chili-chip/chili-utility-module-hardware/3d-models/Vybronics_VZ43FC1B5640007L.step

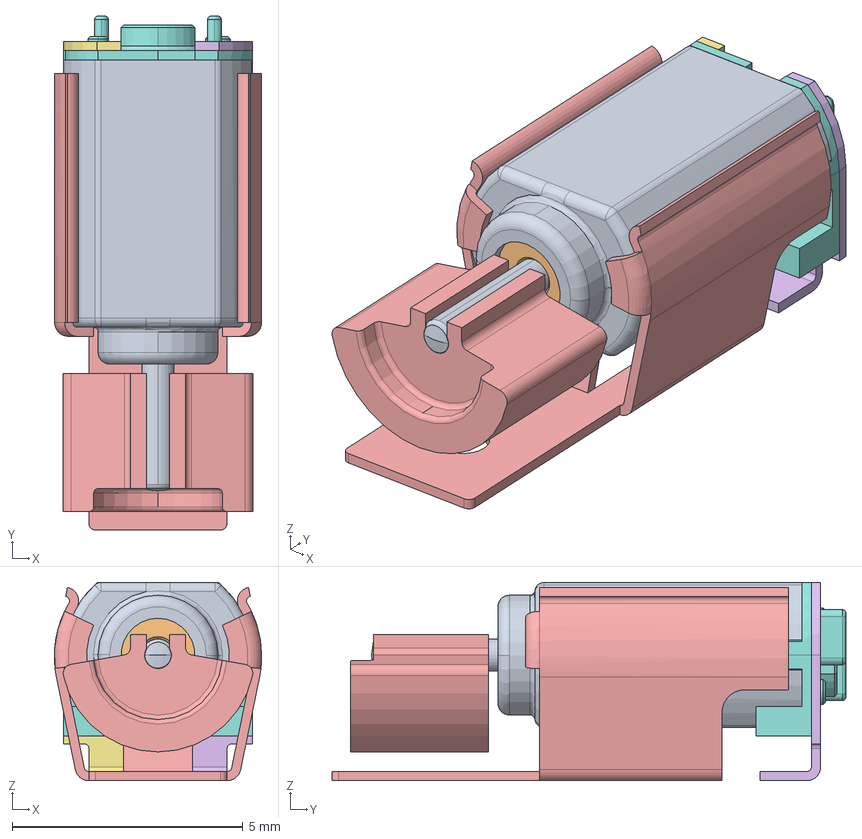
[picture p4: CAD file, 2026-11-06]
3d-models/Vybronics_VZ43FC1B5640007L.step
4.50 x 11.2 x 4.30 mm
SHAFT
PRT0004_1
VARISTOR
WASHER
PRT0004
CP-M_3
CP-M_8
CP-M_1
CP-M_6
CP-M_1_1
CP-M_4
CP-M_10
CP-M
CP-M_9
CP-M_2
CP-M_5
CP-M_12
CP-M_11
CP-M_7
CP-M_1_2
CP-T
COMSLIAO
TAOHUAN
COMTONGP_2
COMTONGP_1
COMTONGP
ZHI_JIA
CASE
METAL_C
MAGNET
MAGNET_1
COUNTER_WEIGHT
BRUSH_SHUATI
BRUSH_CASE
BRUSH_BOARD
BRUSH_CASE-1
BRUSH_SHUATI-1
METAL_E
