chili-chip/chili-utility-module-hardware/3d-models/BatteryHolder_MYOUNG_MY-1220-03.step

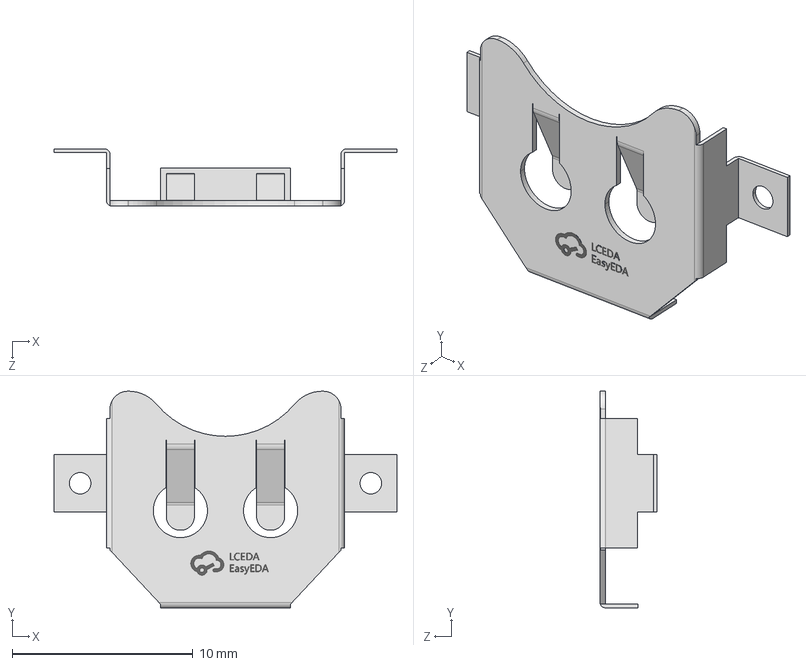
[picture p5: CAD file, 2026-11-05]
3d-models/BatteryHolder_MYOUNG_MY-1220-03.step
19.0 x 12.0 x 3.18 mm
