chili-chip/chili-utility-module-hardware/3d-models/Motor_ERM_LEADER_LCM1027A2445F.step

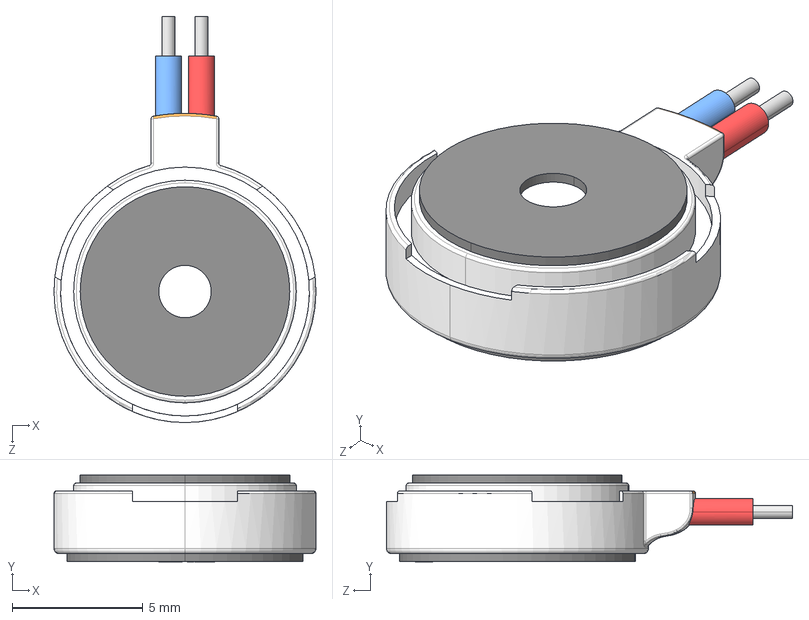
[picture p6: CAD file, 2026-11-05]
3d-models/Motor_ERM_LEADER_LCM1027A2445F.step
10.0 x 3.31 x 15.5 mm
