chili-chip/chili-utility-module-hardware/chili-utility-module.kicad_pcb

## KiCad design chili-utility-module.kicad_pcb (2026-11-05)

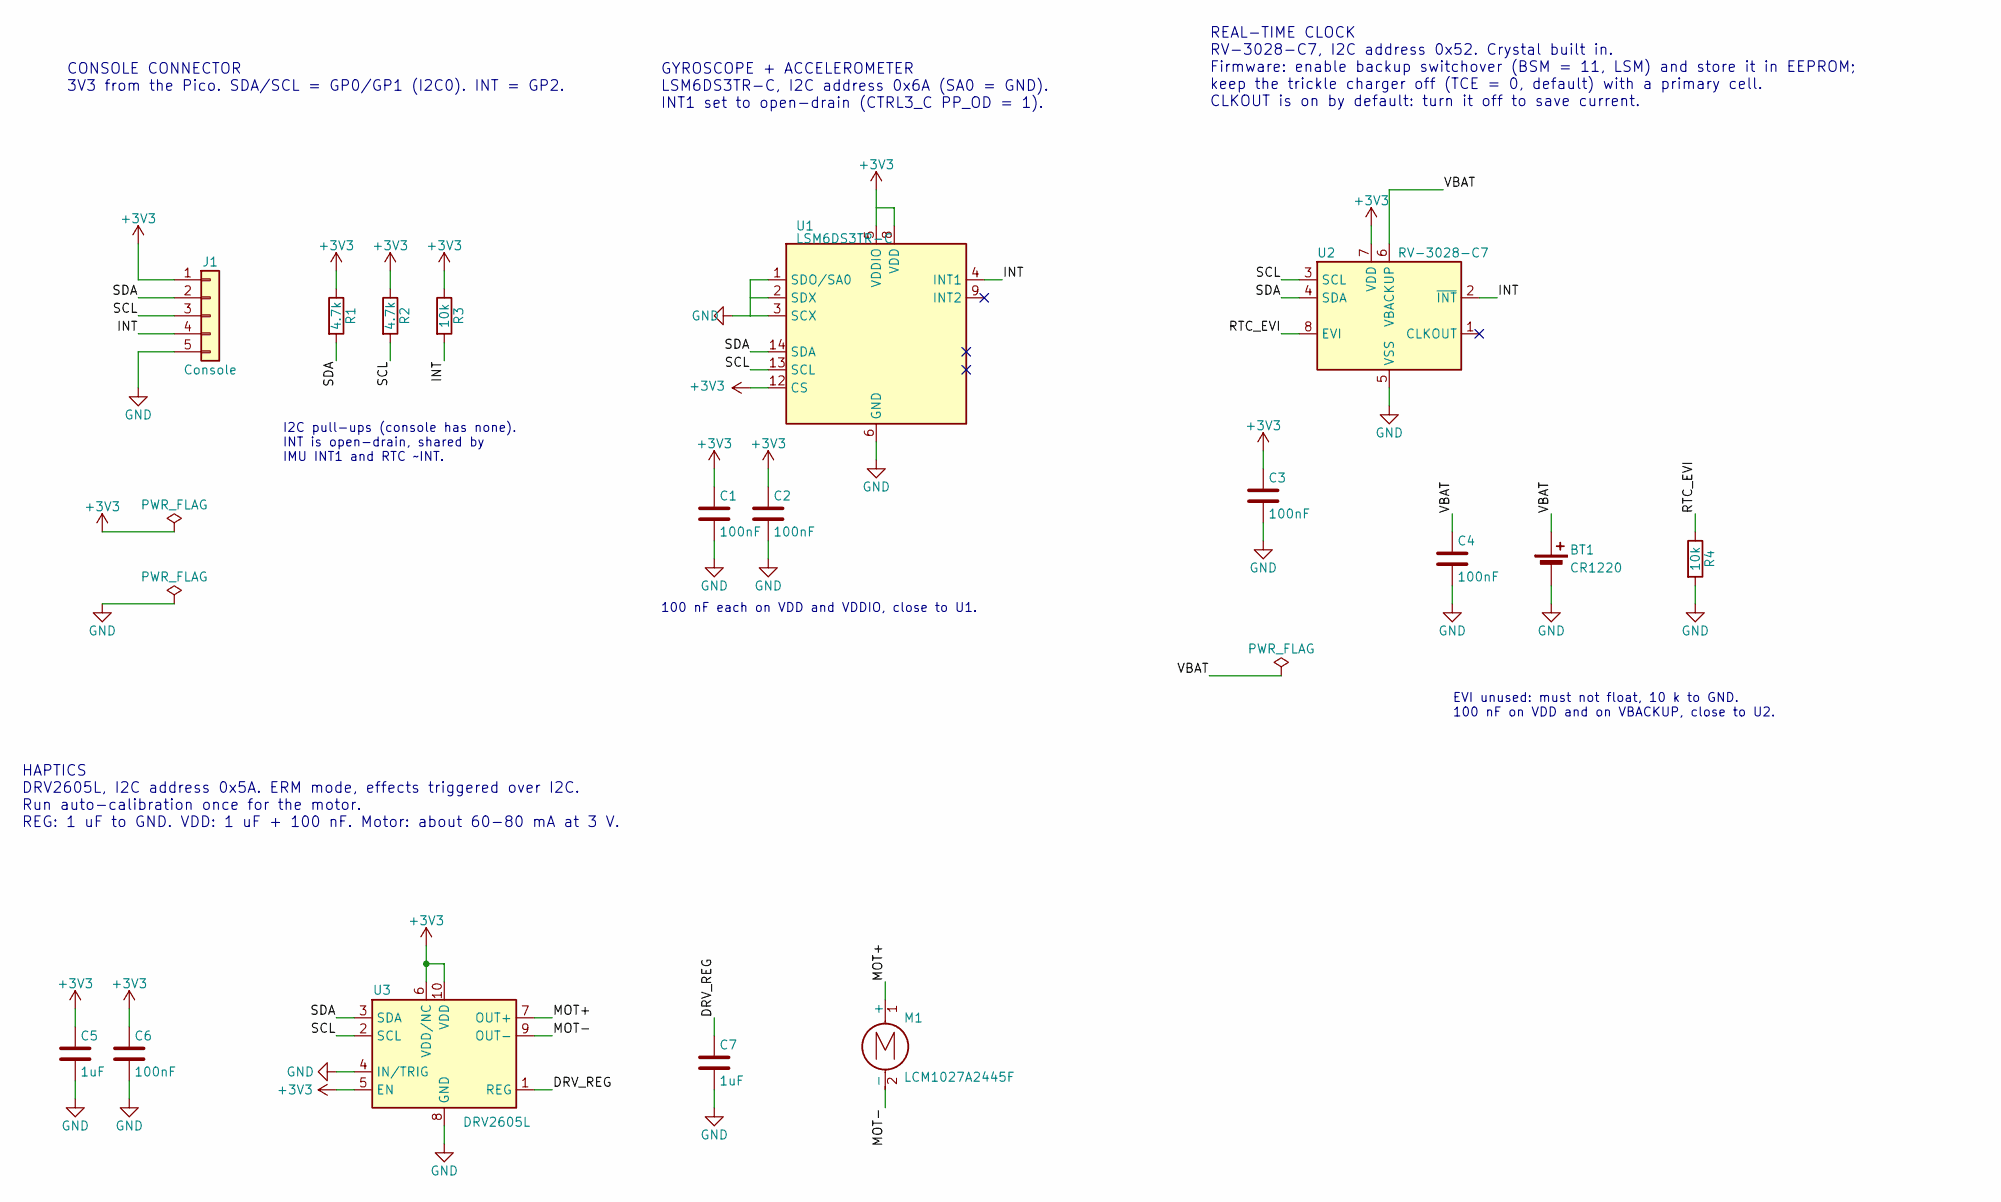
[picture p7: schematic chili-utility-module.kicad_sch, CHILICHIP UTILITY MODULE]

Parts:
BT1: CR1220; BatteryHolder_MYOUNG_MY-1220-03_CR1220; MPN MY-1220-03-R; LCSC C964819
C1, C2, C3, C4, C6: 100nF; C_0402_1005Metric; MPN CL05B104KO5NNNC; LCSC C1525
C5, C7: 1uF; C_0402_1005Metric; MPN CL05A105KA5NQNC; LCSC C52923
J1: Console; Castellated_1x05_P2.54mm
M1: LCM1027A2445F; Motor_ERM_D10mm_WireLeads; MPN LCM1027A2445F; LCSC C2759984
R1, R2: 4.7k; R_0402_1005Metric; MPN 0402WGF4701TCE; LCSC C25900
R3, R4: 10k; R_0402_1005Metric; MPN 0402WGF1002TCE; LCSC C25744
U1: LSM6DS3TR-C; LGA-14_3x2.5mm_P0.5mm_LayoutBorder3x4y; MPN LSM6DS3TR-C; LCSC C967633
U2: RV-3028-C7; MicroCrystal_C7_SON-8_1.5x3.2mm_P0.9mm; MPN RV-3028-C7-32.768kHz-1ppm-TA-QC; LCSC C3019759
U3: DRV2605L; TSSOP-10_3x3mm_P0.5mm; MPN DRV2605LDGSR; LCSC C527464

Connections:
+3V3: C1.1, C2.1, C3.1, C5.1, C6.1, J1.1, R1.1, R2.1, R3.1, U1.5 (VDDIO), U1.8 (VDD), U1.12 (CS), U2.7 (VDD), U3.5 (EN), U3.6 (VDD/NC), U3.10 (VDD)
/DRV_REG: C7.1, U3.1 (REG)
/INT: J1.4, R3.2, U1.4 (INT1), U2.2 (~INT)
/MOT+: M1.1 (+), U3.7 (OUT+)
/MOT-: M1.2 (-), U3.9 (OUT-)
/RTC_EVI: R4.1, U2.8 (EVI)
/SCL: J1.3, R2.2, U1.13 (SCL), U2.3 (SCL), U3.2 (SCL)
/SDA: J1.2, R1.2, U1.14 (SDA), U2.4 (SDA), U3.3 (SDA)
/VBAT: BT1.1 (+), C4.1, U2.6 (VBACKUP)
GND: BT1.2 (-), C1.2, C2.2, C3.2, C4.2, C5.2, C6.2, C7.2, J1.5, R4.2, U1.1 (SDO/SA0), U1.2 (SDX), U1.3 (SCX), U1.6 (GND), U1.7 (GND), U2.5 (VSS), U3.4 (IN/TRIG), U3.8 (GND)

Notes on the sheet:
100 nF each on VDD and VDDIO, close to U1.
CONSOLE CONNECTOR 3V3 from the Pico. SDA/SCL = GP0/GP1 (I2C0). INT = GP2.
I2C pull-ups (console has none). INT is open-drain, shared by IMU INT1 and RTC ~INT.
HAPTICS DRV2605L, I2C address 0x5A. ERM mode, effects triggered over I2C. Run auto-calibration once for the motor. REG: 1 uF to GND. VDD: 1 uF + 100 nF. Motor: about 60-80 mA at 3 V.
GYROSCOPE + ACCELEROMETER LSM6DS3TR-C, I2C address 0x6A (SA0 = GND). INT1 set to open-drain (CTRL3_C PP_OD = 1).
REAL-TIME CLOCK RV-3028-C7, I2C address 0x52. Crystal built in. Firmware: enable backup switchover (BSM = 11, LSM) and store it in EEPROM; keep the trickle charger off (TCE = 0, default) with a primary cell. CLKOUT is on by default: turn it off to save current.
EVI unused: must not float, 10 k to GND. 100 nF on VDD and on VBACKUP, close to U2.

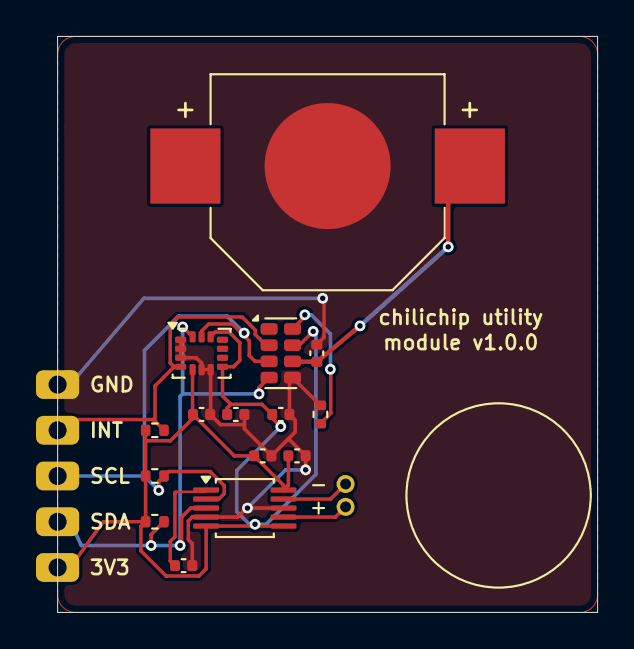
[picture p8: board chili-utility-module.kicad_pcb from above]

Board: 2 copper layers, 30.0 x 32.0 mm, 17 parts (0 on the bottom side), 10 nets.
