chili-chip/chili-utility-module-hardware/(commit log)

2026-11-05 Utility module: part selection, symbols and schematic
    Gyroscope/accelerometer (LSM6DS3TR-C), real-time clock (RV-3028-C7)
    with CR1220 backup, and haptic driver (DRV2605L) with a coin ERM motor,
    all on one I2C bus to the console's GP0/GP1, with a shared open-drain
    INT on GP2.
    - Project symbol library with the four parts (from KiCad 10's library,
    plus manufacturer, part number and LCSC fields).
    - Schematic with decoupling, pull-ups and tie-offs per the datasheets;
    LCSC numbers on every part.
    - README with part choices, J1 pinout, firmware setup and open items.
2026-11-05 Footprints for J1, BT1 and M1; schematic layout
    - New project footprint library chili-utility-module.pretty (fp-lib-table):
    - Castellated_1x05_P2.54mm: same castellated pads as the audio and
    buttons modules.
    - BatteryHolder_MYOUNG_MY-1220-03_CR1220: from MYOUNG drawing
    MY-CP-0210 and LCSC's EasyEDA footprint; two + tabs at +-7.9 mm,
    round 7 mm - pad under the cell.
    - Motor_ERM_D10mm_WireLeads: 10 mm coin motor body with two 0.6 mm
    plated holes for its wire leads.
    - Assign them to J1, BT1 and M1; all parts now have footprints.
    - LSM6DS3TR-C symbol: INT1/INT2 typed open-collector, since the design
    always runs them open-drain on the shared INT line. ERC now shows only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
2026-11-05 PCB: board outline and placement
    - 30 x 32 mm board, rounded corners, all parts on the top side (the
    bottom sits on the console once the castellations are soldered).
    - Coin cell holder along the top; IMU and RTC under it, the IMU as far
    from the motor as possible; I2C/INT pull-ups level with their J1
    castellations; haptic driver next to the motor's lead pads; motor in
    the bottom-right corner.
    - Silkscreen: J1 pin labels and the module name/version; reference
    designators on F.Fab (0402 parts are too dense for silk refs).
    - Default clearance 0.15 mm so the LSM6DS3TR-C LGA-14 pads pass DRC
    (JLCPCB minimum 0.127 mm). Motor lead pads 1.0 mm for a 0.27 mm gap.
    - J1 symbol excluded from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
2026-11-05 PCB: routed board, GND pour, coin cell keepout
    - Autorouted with Freerouting (GND included), then cleaned up by hand.
    GND pour on both layers: SMD pads solid, THT pads thermal, J1 GND
    castellation solid.
    - BT1 (CR1220 holder): no-tracks/no-vias keepout over the cell, since
    its underside is the - terminal, so only GND pour sits under it. The
    two + tabs are an internal jumper (duplicate pad numbers), so no
    track crosses under the cell. Updated in the library too.
    - VBAT routed around the cell on B.Cu to a + tab.
    - J1 track ends pulled 0.7 mm in from the board edge.
    - Default clearance and minimum track width 0.15 mm.
    - README: PCB section and status.
    DRC: 0 violations, 0 unconnected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
2026-11-05 CI and 3D models
    - 3D models for every part: LCSC's STEP models for the CR1220 holder
    (BT1), the coin motor (M1) and the RV-3028-C7 (U2), in 3d-models/.
    U2 uses a project copy of KiCad's MicroCrystal C7 SON-8 footprint,
    because KiCad 10 doesn't ship the model it references.
    - CI: KiCad 10 ERC/DRC plus a jlcpcb job, as in the audio module.
    scripts/export-jlcpcb.sh builds the gerber zip, BOM and CPL; BOM
    references are plain comma lists, and parts missing from the CPL
    (the hand-soldered motor) are left out of the BOM. Releases attach
    the files.
    - README: 3D model notes and JLCPCB ordering steps.
    DRC: 0 violations, 0 unconnected, 0 schematic parity issues.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
2026-11-05 v1.0.0: version bump, 3D model offsets
    - Bump to v1.0.0 in the schematic and board title blocks, project
    settings and the front silkscreen.
    - 3D models: holder raised 3.1 mm and motor 1.7 mm so they sit on the
    board (their STEP origins aren't at the base); synced to the library
    footprints.
2026-11-05 ERC clean for CI: IMU SA0/SDx pins passive
    The KiCad CI action fails on any ERC message. SDO/SA0 and SDx are tied
    to GND in this design (address strap and unused aux I2C master), so
    type them passive in the project's LSM6DS3TR-C symbol instead of
    bidirectional. ERC now reports 0 messages. README ERC section updated.
2026-11-05 README: four adjusted pin types, not three
2026-11-05 README: board renders
    Add top, bottom and 3D renders (docs/images) and scripts/render-images.sh
    to regenerate them.
2026-11-06 Merge pull request #1 from chili-chip/v2.0.0-slim
    v2.0.0: 16.4 x 14.8 mm module, LiPo-backed RTC, SMD motor
